mnorden81/CRSF-Multiswitch-Sound-ESP32-S3/firmware/README.md

# Firmware RC-Multiswitch-Sound v1.00

Arduino-Sketch `RC_Multiswitch_Sound/` fuer die Platine v0.9 mit ESP32-S3-DevKitC-1 N16R8. Nicht auf Hardware getestet.

Reine Zusammenfuehrung von RC-Multiswitch-ESP32-S3 v4.06 (Schaltteil, = Multiswitch-Basis V3/TXRX) und ESP32-Sound-Basis_Ziege-One v7.21 (Soundteil). Was neu ist, steht im Kopf von `RC_Multiswitch_Sound.ino`.

## Arduino IDE
1. Board-Verwalter: **esp32 von Espressif, Version 3.0.7**.
2. Bibliotheken: **Bolder Flight Systems SBUS 8.1.4**, **TinyGPSPlus 1.0.3**.
3. `RC_Multiswitch_Sound/RC_Multiswitch_Sound.ino` oeffnen.
4. Werkzeuge:
   - Board: **ESP32S3 Dev Module**
   - USB CDC On Boot: **Enabled**
   - Partition Scheme: **Minimal SPIFFS (1.9MB APP with OTA/128KB SPIFFS)**
   - PSRAM: Disabled
5. Hochladen. Danach gehen Updates auch per WLAN (Reiter WiFi, Firmware-Update) mit der Datei `RC_Multiswitch_Sound.ino.bin`.

Fertige Dateien baut GitHub Actions bei jedem Push (Artefakt `RC_Multiswitch_Sound-S3`): `*.ino.bin` = Update per WLAN, `*.merged.bin` = Komplett-Image ab Adresse 0x0 fuer USB.

## Dateien
| Datei | Inhalt |
|---|---|
| `RC_Multiswitch_Sound.ino` | Schaltteil (Ausgaenge, CRSF/SBUS, Lua-Menue, NVS "msw"), Ablauf setup/loop |
| `board_config.h` | Pins der Platine v0.9 |
| `webui.h` | Webserver und API des Schaltteils (`/api/status`, `/api/config`, `/api/output`, ...) |
| `webui_page.h` | Die Web-Seite (Schalt- und Soundteil zusammen) |
| `sound.h`, `sound.cpp` | Soundteil: Einstellungen (NVS "snd"), Wiedergabe, Motor, Einkanal, Lua-Felder |
| `sound_web.cpp` | API des Soundteils (`/api/sconfig`, `/api/sound`, `/api/debug`, SD-Dateien) |
| `XT_I2S_Audio.*` | I2S-Audio und WAV von der SD-Karte, unveraendert aus der Sound-Basis |
| `src/RC_Common/` | Gemeinsame Basis 1.2.0, unveraenderte Kopie (CI prueft `MANIFEST.sha256`) |

## SD-Karte
FAT32, Dateien im Hauptordner: `start.wav`, `loop.wav`, `shut.wav` (Motor) und `sound1.wav` bis `sound24.wav`. Hochladen geht auch per WLAN (Reiter Motor und Sounds). Sicherungen auf der Karte liegen in `/cfgbkup`.

## Lua-Menue (CRSF)
| Feld | Inhalt |
|---|---|
| 0-85 | wie RC-Multiswitch v4.06: Global (Switch Addr, CRSF Kanal), Ausgang 1-8, WLAN, UART B/C |
| 86-98 | Motor |
| 99-110 | Einstellungen: Sound-Adresse, RC-System, Sound-Einkanal (SBUS), Gruppenadressen, SBUS-Gruppen, WLAN jetzt |
| 111 | Geraetename |
| ab 112 | Sound 1 bis n, je 6 Felder; n = 8 (Vorgabe), 12, 16, 20 oder 23 (Web-UI, Reiter RC-System, Karte Kombimodul) |

Mehr als 23 Sounds passen nicht ins Lua-Menue (hoechstens 255 Felder). In der Web-UI sind immer alle 24 Sounds einstellbar.

## Bekannte Grenzen
- SBUS: Ohne Frames gilt das Signal nach 10 s als weg (Wert des Schaltteils, die Sound-Basis hatte 2 s). Bis dahin laufen Sounds weiter.
- RC-System, UART B/C, Status-LED und die Zahl der Lua-Sounds wirken erst nach einem Neustart.
