mnorden81/CRSF-Multiswitch-Sound-ESP32-S3/hardware/gehaeuse/Gehaeuse3D_Vorschau_gewinkelt.html

# Gehäuse Multiswitch-Sound S3, gewinkelte Stiftleiste

Version für eine gewinkelte Stiftleiste 2×8 (2,54 mm) an J1. Die Stecker der 8 Ausgänge kommen vorne durch die Wand, der Deckel ist über J1 geschlossen. Unterteil und Deckel für die Platine RC-Multiswitch-Sound-ESP32-S3 v0.9. Alle Maße stammen aus der KiCad-Datei, die Bauteilhöhen sind Annahmen (unten markiert).

Außen117,2 × 78,2

Höhe34,6 mm

Platine106 × 68,15

Ziehen = drehen · Mausrad/zwei Finger = zoomen · rechte Maustaste = schieben

Zustand Zu Deckel ab Explosion

Ansicht Schräg Links (USB, SD, A, 3S) Vorne (B, C, Lautspr.) Oben Unten

Zeigen Platine Deckel Deckel durchsichtig

## Öffnungen

Wand | Wofür | Größe B × H
links | USB-C des ESP32 (beide Buchsen) | 26,0 × 9,0
links | microSD-Karte, mit Griffmulde | 16,0 × 6,8
links | CN1 UART A (Empfänger) | 11,5 × 7,0
links | CN2 Akku 3S (Last 9-12,6 V) | 7,5 × 7,0
vorne | J5 UART B, J6 UART C | je 11,5 × 7,0
vorne | CN4 Lautsprecher | 7,5 × 7,0
vorne | J1 gewinkelte Stiftleiste 2×8, 8 Stecker 2-polig nebeneinander | 21,5 × 6,2
Deckel | Fenster BOOT/RESET und RGB-LED | 8,4 × 25,0
Deckel | 8 Lichtlöcher Kontroll-LEDs | Ø 3,4
Deckel | 9 Lüftungsschlitze über TPA3118 | 2 × 24
rechts | 6 Lüftungsschlitze | 2 × 12

## Annahmen, bitte prüfen

- Gewinkelte Leiste nach KiCad-Footprint PinHeader_2x08_P2.54mm_Horizontal: Kunststoff 5,1 mm hoch, steht ca. 0,6 mm über die Platinenkante, Pins ragen ca. 3,8 mm aus der Außenwand. Gelötet wird in die vorhandenen Löcher, die Platine bleibt unverändert. Oben liegen die Ausgänge, unten VLOAD.
- Innenhöhe 24 mm über der Platine. Das höchste Teil ist der Elko C1 (470 µF/35 V, jetzt 22 mm hoch angenommen), darüber 2 mm Luft.
- ESP sitzt 13 mm hoch (Unterkante ESP-Platine über der Hauptplatine). Danach richten sich USB-Ausschnitt und Fenster.
- Befestigung der Platine: Die Platine hat keine eigenen Montagelöcher. Ich nutze die 4 Löcher (3 mm) des TPA3118-Moduls, die durch Modul und Platine gehen. Dazu 6 Stützen am Rand.
- Kontroll-LEDs sitzen 19 mm unter dem Deckel. Durch die Löcher sieht man sie leuchten. Wer sie direkt im Deckel haben will, lötet sie mit langen Beinen ein.
- Lage von BOOT, RESET und RGB-LED auf dem DevKitC-1 ist nicht in der KiCad-Datei. Deshalb ein großes Fenster am USB-Ende statt einzelner Löcher.

## Drucken und Montieren

- Material PETG oder ASA (der TPA3118 wird warm, PLA kann weich werden). 0,2 mm Schicht, 3 Wände, 20 % Füllung.
- Unterteil mit dem Boden aufs Bett, Deckel mit der Oberseite aufs Bett (STL ist schon gedreht). Keine Stützen nötig.
- Platine: 4 × M3-Schraube von oben durch TPA3118-Modul und Platine in die Säulen (Kernloch 2,5 mm, selbstschneidend, Länge je nach Modulabstand ca. M3 × 16-20).
- Deckel: 4 × Blechschraube 2,5 × 8 (Senkkopf) in die Eckdome.
- Einbau ins Modell: 4 Laschen mit 3,4 mm Loch am Boden für Schrauben oder Kabelbinder.
- Wandstärke 2,2 mm, Boden und Deckel 2,0 mm, 5 mm Luft unter der Platine für Lötstellen.

## Dateien

- Gehaeuse_Unterteil_gewinkelt.stl / .step
- Gehaeuse_Deckel_gewinkelt.stl / .step
- gehaeuse.py --gewinkelt (Quelle, CadQuery, alle Maße als Parameter oben in der Datei)

STEP lässt sich in Fusion 360, FreeCAD oder KiCad öffnen und weiter ändern.
