mnorden81/CRSF-Multiswitch-Sound-ESP32-S3/hardware/gehaeuse/gehaeuse_links.png

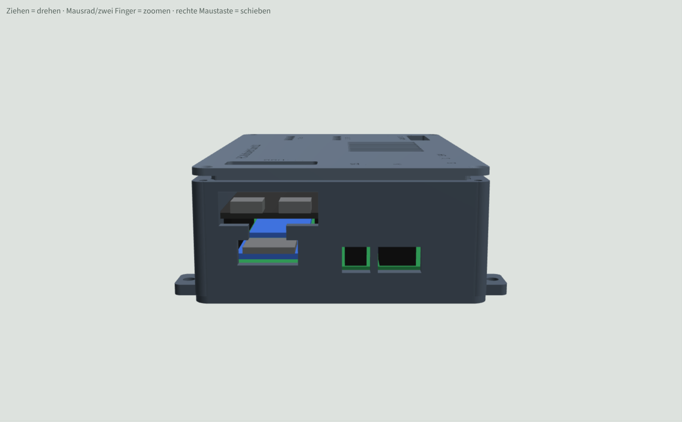
hardware/gehaeuse/gehaeuse_links.png
