mnorden81/CRSF-Multiswitch-Sound-ESP32-S3/hardware/gehaeuse/Gehaeuse_Deckel_gewinkelt.step

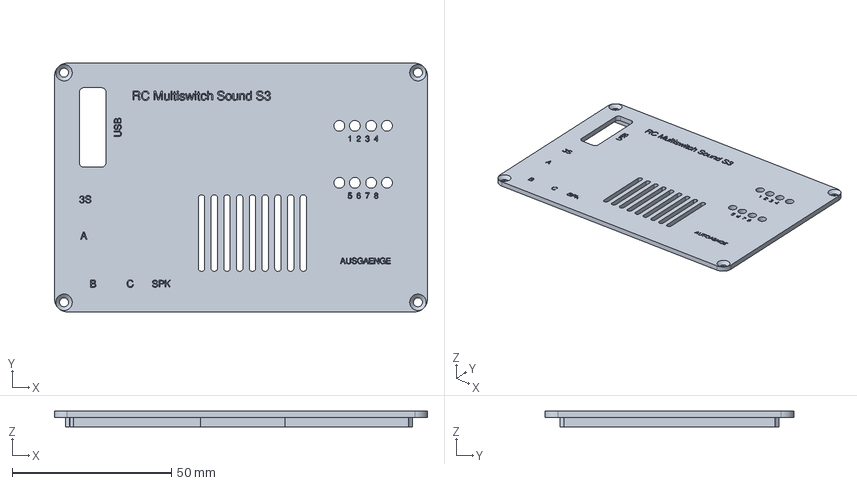
[picture p5: CAD file, 2026-10-30]
hardware/gehaeuse/Gehaeuse_Deckel_gewinkelt.step
117.2 x 78.2 x 5.00 mm
