mnorden81/CRSF-Multiswitch-Sound-ESP32-S3/hardware/RC-Multiswitch-Sound-ESP32-S3.pdf

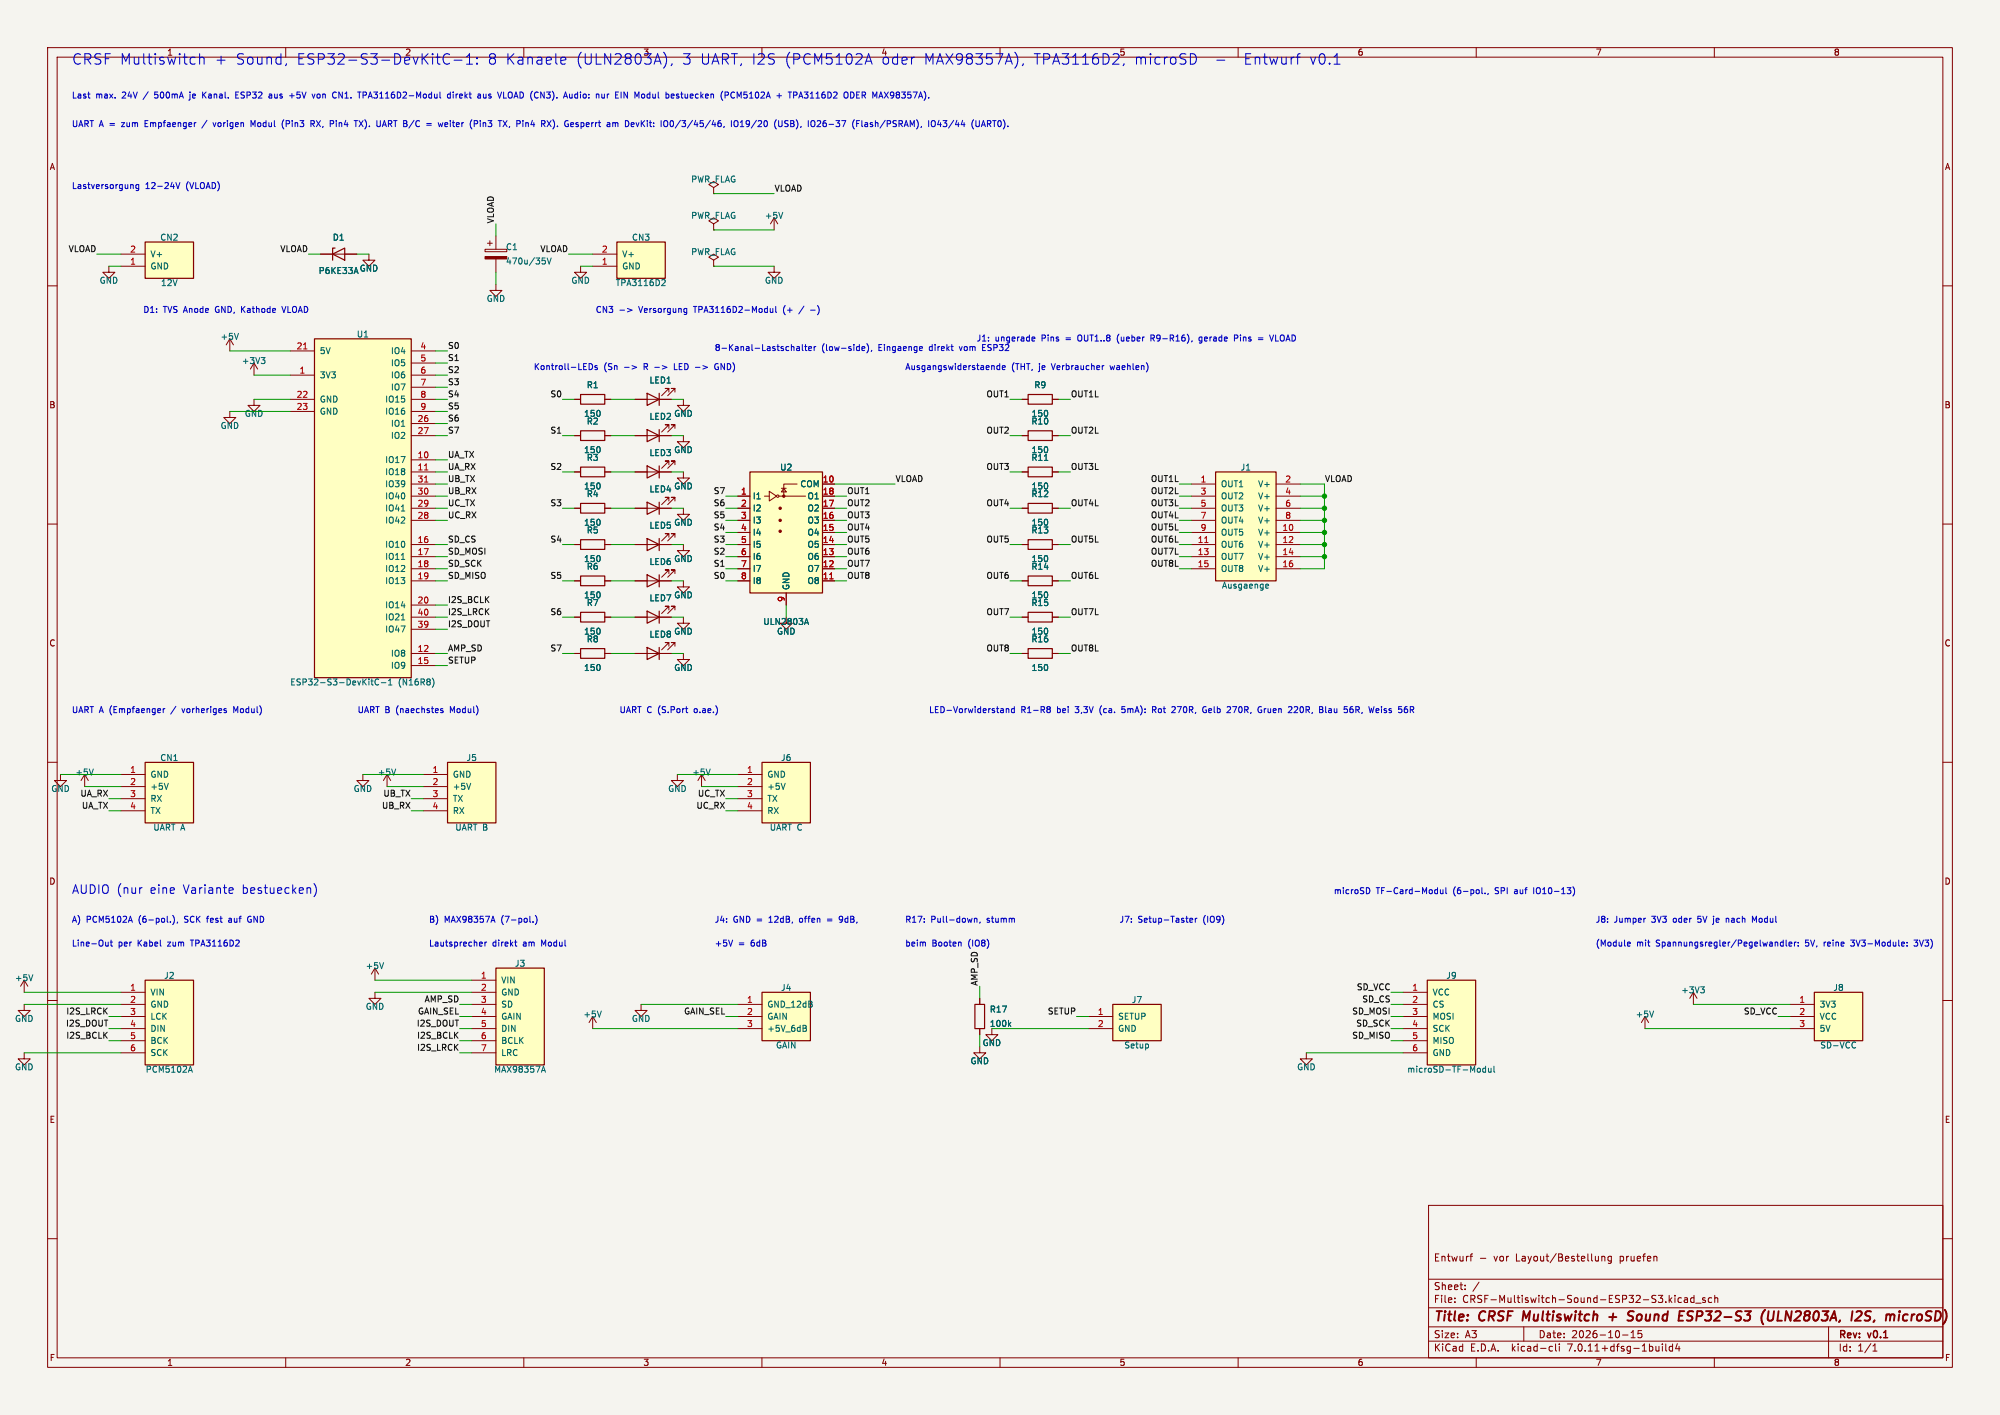
[picture p6: page 1]

D1: TVS Anode GND, Kathode VLOAD

AUDIO (nur eine Variante bestuecken)
