mnorden81/CRSF-Multiswitch-Sound-ESP32-S3/hardware/RC-Multiswitch-Sound-ESP32-S3.kicad_pcb

## KiCad design hardware/RC-Multiswitch-Sound-ESP32-S3.kicad_pcb (2026-10-30)

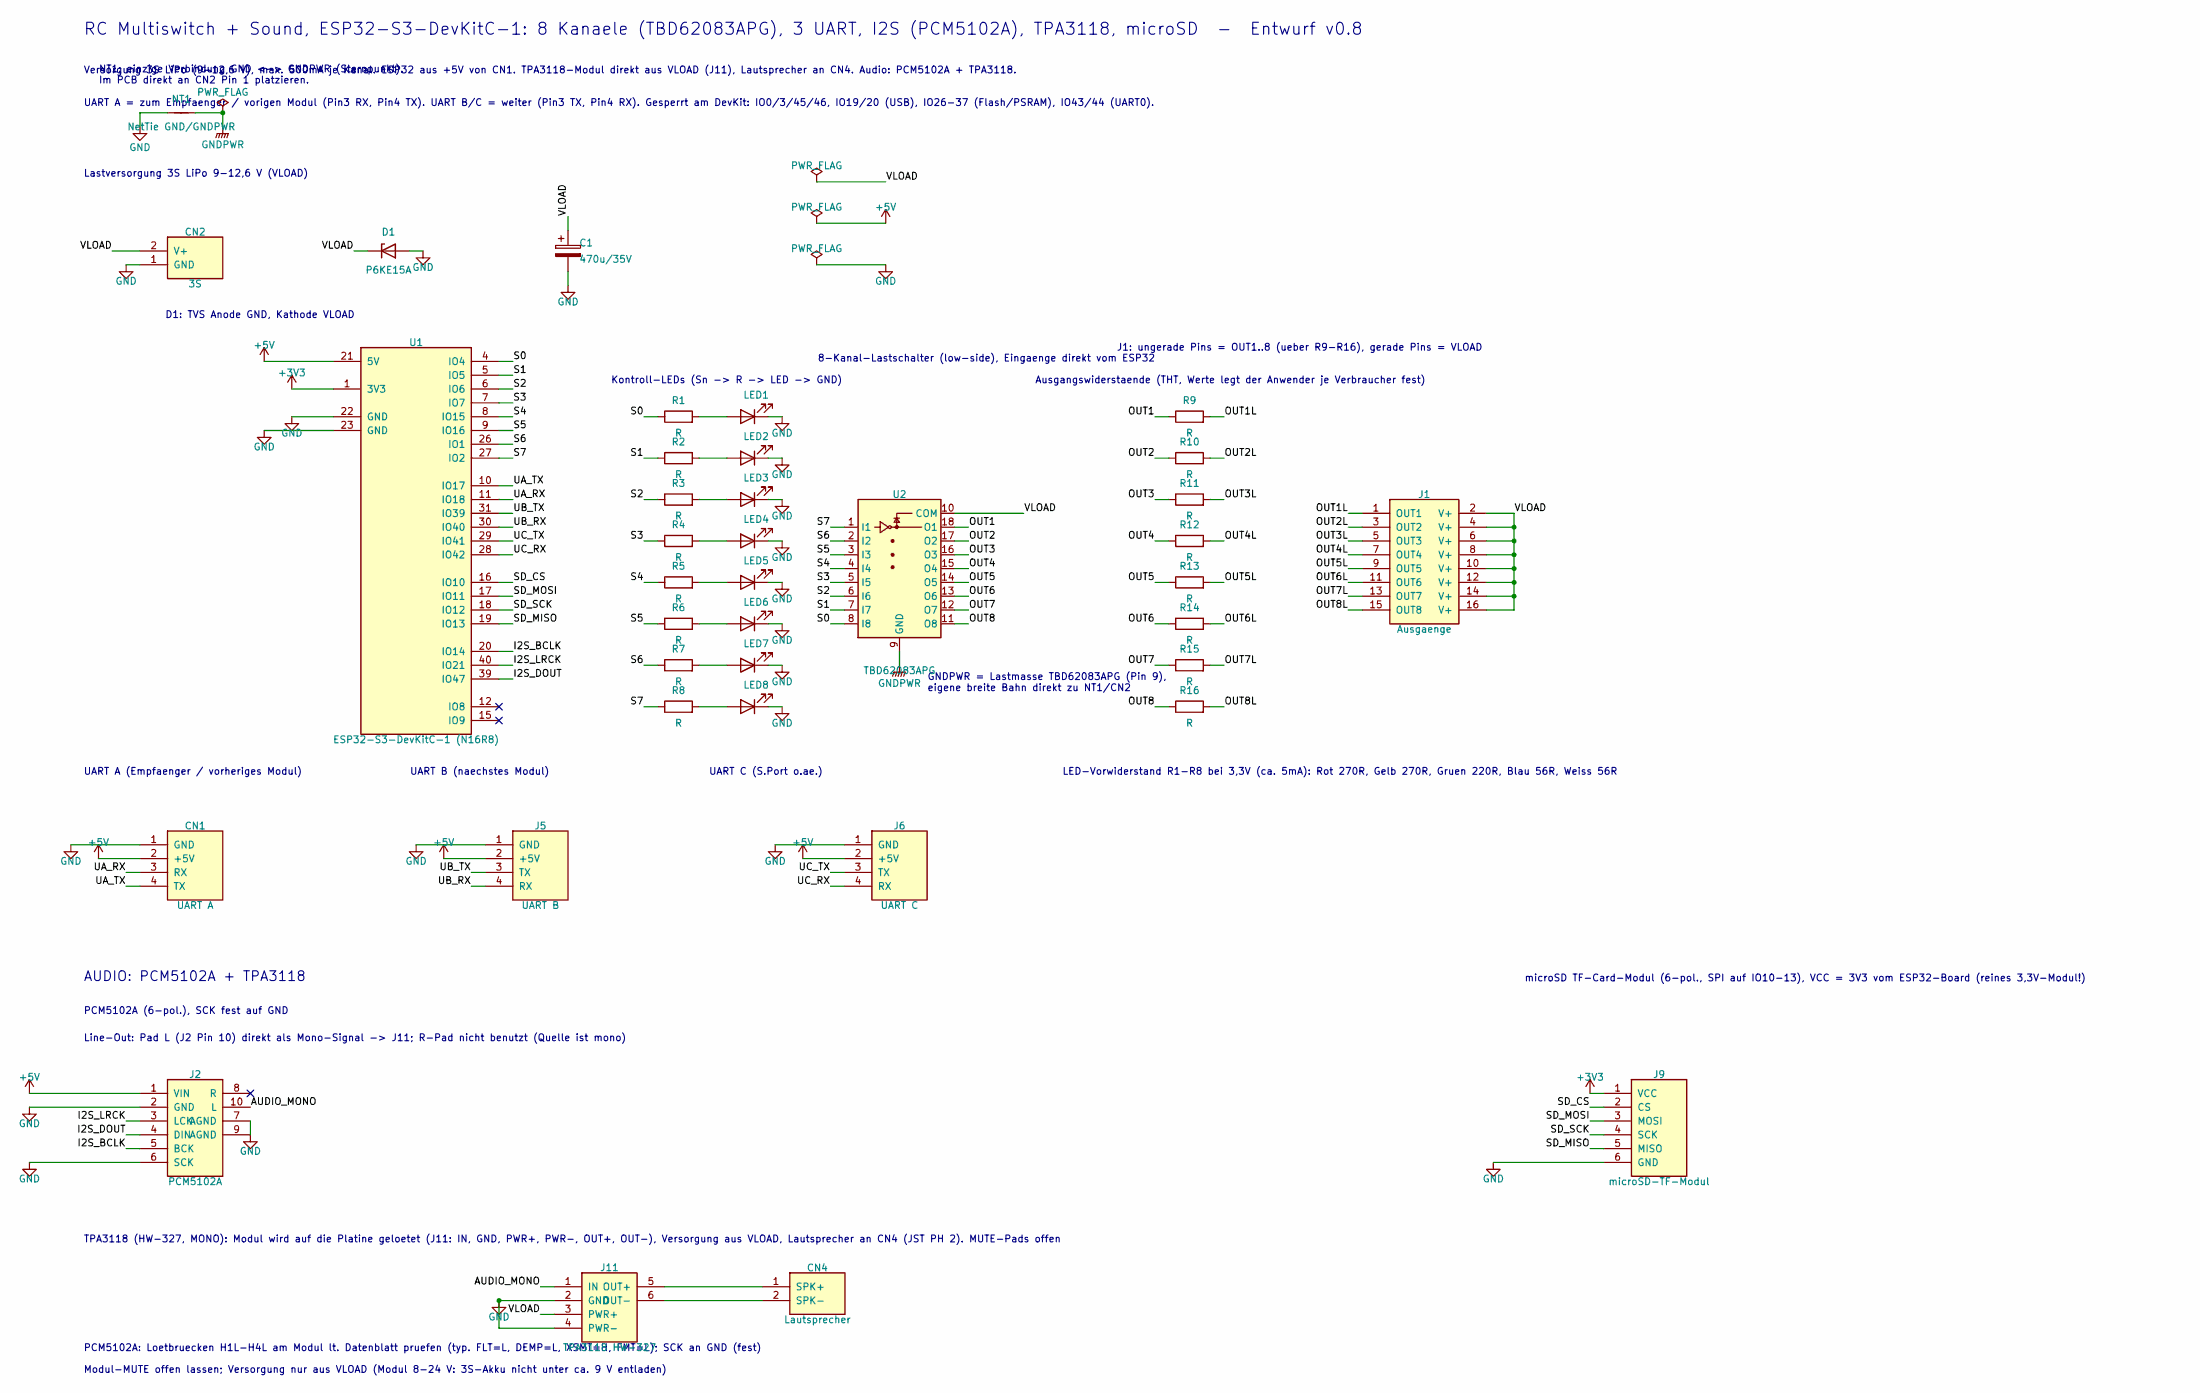
[picture p7: schematic RC-Multiswitch-Sound-ESP32-S3.kicad_sch, RC Multiswitch + Sound ESP32-S3 (TBD62083APG, I2S, microSD)]

Parts:
C1: 470u/35V; CP_Radial_D10.0mm_P5.00mm
CN1: UART A; JST_PH_S4B-PH-K_1x04_P2.00mm_Horizontal
CN2: 3S; JST_PH_S2B-PH-K_1x02_P2.00mm_Horizontal
CN4: Lautsprecher; JST_PH_S2B-PH-K_1x02_P2.00mm_Horizontal
D1: P6KE15A; D_DO-15_P12.70mm_Horizontal
J1: Ausgaenge; PinHeader_2x08_P2.54mm_Vertical
J2: PCM5102A; Mod_PCM5102A_GY_THT
J5: UART B; JST_PH_S4B-PH-K_1x04_P2.00mm_Horizontal
J6: UART C; JST_PH_S4B-PH-K_1x04_P2.00mm_Horizontal
J9: microSD-TF-Modul; Mod_microSD_SPI_THT
J11: TPA3118 HW-327; Mod_TPA3118_HW327_THT
LED1, LED2, LED3, LED4, LED5, LED6, LED7, LED8: LED; LED_D3.0mm
NT1: NetTie GND/GNDPWR; NetTie-2_SMD_Pad2.0mm
R1, R2, R3, R4, R5, R6, R7, R8, R9, R10, R11, R12, R13, R14, R15, R16: R; R_Axial_DIN0207_L6.3mm_D2.5mm_P7.62mm_Horizontal
U1: ESP32-S3-DevKitC-1 (N16R8); ESP32-S3-DevKitC-1_THT
U2: TBD62083APG; DIP-18_W7.62mm_Socket

Connections:
+3V3: J9.1 (VCC), U1.1 (3V3)
+5V: CN1.2 (+5V), J2.1 (VIN), J5.2 (+5V), J6.2 (+5V), U1.21 (5V)
/AUDIO_MONO: J2.10 (L), J11.1 (IN)
/I2S_BCLK: J2.5 (BCK), U1.20 (IO14)
/I2S_DOUT: J2.4 (DIN), U1.39 (IO47)
/I2S_LRCK: J2.3 (LCK), U1.40 (IO21)
/OUT1: R9.1, U2.18 (O1)
/OUT1L: J1.1 (OUT1), R9.2
/OUT2: R10.1, U2.17 (O2)
/OUT2L: J1.3 (OUT2), R10.2
/OUT3: R11.1, U2.16 (O3)
/OUT3L: J1.5 (OUT3), R11.2
/OUT4: R12.1, U2.15 (O4)
/OUT4L: J1.7 (OUT4), R12.2
/OUT5: R13.1, U2.14 (O5)
/OUT5L: J1.9 (OUT5), R13.2
/OUT6: R14.1, U2.13 (O6)
/OUT6L: J1.11 (OUT6), R14.2
/OUT7: R15.1, U2.12 (O7)
/OUT7L: J1.13 (OUT7), R15.2
/OUT8: R16.1, U2.11 (O8)
/OUT8L: J1.15 (OUT8), R16.2
/S0: R1.1, U1.4 (IO4), U2.8 (I8)
/S1: R2.1, U1.5 (IO5), U2.7 (I7)
/S2: R3.1, U1.6 (IO6), U2.6 (I6)
/S3: R4.1, U1.7 (IO7), U2.5 (I5)
/S4: R5.1, U1.8 (IO15), U2.4 (I4)
/S5: R6.1, U1.9 (IO16), U2.3 (I3)
/S6: R7.1, U1.26 (IO1), U2.2 (I2)
/S7: R8.1, U1.27 (IO2), U2.1 (I1)
/SD_CS: J9.2 (CS), U1.16 (IO10)
/SD_MISO: J9.5 (MISO), U1.19 (IO13)
/SD_MOSI: J9.3 (MOSI), U1.17 (IO11)
/SD_SCK: J9.4 (SCK), U1.18 (IO12)
/UA_RX: CN1.3 (RX), U1.11 (IO18)
/UA_TX: CN1.4 (TX), U1.10 (IO17)
/UB_RX: J5.4 (RX), U1.30 (IO40)
/UB_TX: J5.3 (TX), U1.31 (IO39)
/UC_RX: J6.4 (RX), U1.28 (IO42)
/UC_TX: J6.3 (TX), U1.29 (IO41)
/VLOAD: C1.1, CN2.2 (V+), D1.1 (K), J1.2 (V+), J1.4 (V+), J1.6 (V+), J1.8 (V+), J1.10 (V+), J1.12 (V+), J1.14 (V+), J1.16 (V+), J11.3 (PWR+), U2.10 (COM)
GND: C1.2, CN1.1 (GND), CN2.1 (GND), D1.2 (A), J2.2 (GND), J2.6 (SCK), J2.7 (AGND), J2.9 (AGND), J5.1 (GND), J6.1 (GND), J9.6 (GND), J11.2 (GND), J11.4 (PWR-), LED1.1 (K), LED2.1 (K), LED3.1 (K), LED4.1 (K), LED5.1 (K), LED6.1 (K), LED7.1 (K), LED8.1 (K), NT1.1, U1.22 (GND), U1.23 (GND)
GNDPWR: NT1.2, U2.9 (GND)
unnamed: CN4.1 (SPK+), J11.5 (OUT+)
unnamed: CN4.2 (SPK-), J11.6 (OUT-)
unnamed: LED1.2 (A), R1.2
unnamed: LED2.2 (A), R2.2
unnamed: LED3.2 (A), R3.2
unnamed: LED4.2 (A), R4.2
unnamed: LED5.2 (A), R5.2
unnamed: LED6.2 (A), R6.2
unnamed: LED7.2 (A), R7.2
unnamed: LED8.2 (A), R8.2

Notes on the sheet:
D1: TVS Anode GND, Kathode VLOAD
Versorgung 3S LiPo (9-12,6 V), max. 500mA je Kanal. ESP32 aus +5V von CN1. TPA3118-Modul direkt aus VLOAD (J11), Lautsprecher an CN4. Audio: PCM5102A + TPA3118.
AUDIO: PCM5102A + TPA3118
Ausgangswiderstaende (THT, Werte legt der Anwender je Verbraucher fest)
LED-Vorwiderstand R1-R8 bei 3,3V (ca. 5mA): Rot 270R, Gelb 270R, Gruen 220R, Blau 56R, Weiss 56R
PCM5102A: Loetbruecken H1L-H4L am Modul lt. Datenblatt pruefen (typ. FLT=L, DEMP=L, XSMT=H, FMT=L); SCK an GND (fest)
J1: ungerade Pins = OUT1..8 (ueber R9-R16), gerade Pins = VLOAD
Line-Out: Pad L (J2 Pin 10) direkt als Mono-Signal -> J11; R-Pad nicht benutzt (Quelle ist mono)
RC Multiswitch + Sound, ESP32-S3-DevKitC-1: 8 Kanaele (TBD62083APG), 3 UART, I2S (PCM5102A), TPA3118, microSD - Entwurf v0.8
microSD TF-Card-Modul (6-pol., SPI auf IO10-13), VCC = 3V3 vom ESP32-Board (reines 3,3V-Modul!)
PCM5102A (6-pol.), SCK fest auf GND
UART A (Empfaenger / vorheriges Modul)
Modul-MUTE offen lassen; Versorgung nur aus VLOAD (Modul 8-24 V: 3S-Akku nicht unter ca. 9 V entladen)
Lastversorgung 3S LiPo 9-12,6 V (VLOAD)
UART C (S.Port o.ae.)
Kontroll-LEDs (Sn -> R -> LED -> GND)
UART A = zum Empfaenger / vorigen Modul (Pin3 RX, Pin4 TX). UART B/C = weiter (Pin3 TX, Pin4 RX). Gesperrt am DevKit: IO0/3/45/46, IO19/20 (USB), IO26-37 (Flash/PSRAM), IO43/44 (UART0).
UART B (naechstes Modul)
TPA3118 (HW-327, MONO): Modul wird auf die Platine geloetet (J11: IN, GND, PWR+, PWR-, OUT+, OUT-), Versorgung aus VLOAD, Lautsprecher an CN4 (JST PH 2). MUTE-Pads offen
8-Kanal-Lastschalter (low-side), Eingaenge direkt vom ESP32
NT1: einzige Verbindung GND <-> GNDPWR (Sternpunkt). Im PCB direkt an CN2 Pin 1 platzieren.
GNDPWR = Lastmasse TBD62083APG (Pin 9), eigene breite Bahn direkt zu NT1/CN2

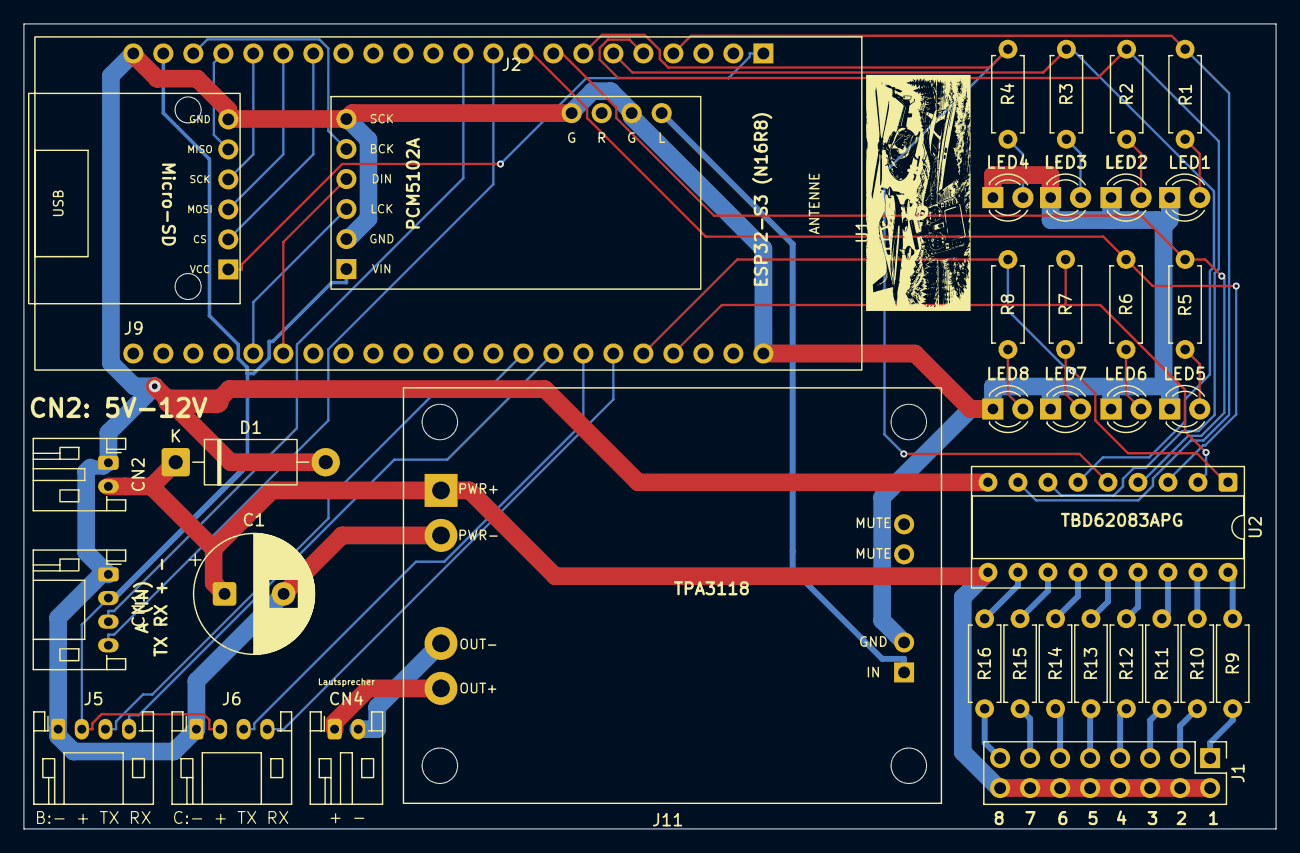
[picture p8: board RC-Multiswitch-Sound-ESP32-S3.kicad_pcb from above]

Board: 2 copper layers, 106.0 x 68.2 mm, 38 parts (0 on the bottom side), 53 nets.
