mnorden81/CRSF-Multiswitch-Sound-ESP32-S3/(commit log)

2026-10-16 Ausgangsstand aus KiCad-ZIP vom 2026-10-15
    Hardware nach hardware/, leerer Ordner firmware/, README und .gitignore.
    Claude-Session: https://claude.ai/code/session_017Lns5pPfH18AXUiHEWcrs9
    [CRSF-Multiswitch-Sound-ESP32-S3.kicad_pcb, CRSF-Multiswitch-Sound-ESP32-S3.kicad_sch]
2026-10-16 Projektbeschreibung in README und docs/Projektbeschreibung.docx
    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
2026-10-18 Umbenennung CRSF-Multiswitch -> RC-Multiswitch
    Neutraler Name, weil der Multiswitch neben CRSF auch SBUS versteht.
    README, docs (MD und DOCX), KiCad-Projekt (Dateinamen, Projekt- und
    Sheet-Verweise, Titel), Sketch-Ordner und CI-Pfad angepasst.
    Geraetename, WLAN-SSID und Config-Export bleiben "MultiSwitch".
    Claude-Session: https://claude.ai/code/session_01Np9GkYmRMGJmd89YiKPa21
    [RC-Multiswitch-Sound-ESP32-S3.kicad_pcb, RC-Multiswitch-Sound-ESP32-S3.kicad_sch]
2026-10-18 Lokale KiCad-Staende vom 2026-10-17/18 uebernehmen
    Die Arbeit lag nur lokal (nicht auf GitHub) und wurde beim Abgleich
    nach der Umbenennung ueberschrieben. Wiederhergestellt aus
    backups/vor-umbenennung, Dateinamen und Projektverweise auf
    RC-Multiswitch angepasst.
    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
    [RC-Multiswitch-Sound-ESP32-S3.kicad_pcb, RC-Multiswitch-Sound-ESP32-S3.kicad_sch]
2026-10-18 Widerstandswerte R1-R16 entfernt, Anwender legt sie aus
    - R1-R16 ohne Wert (Schaltplan + PCB), Hinweis im Schaltplan angepasst
    - Projektbeschreibung, README, README-hardware: Anwender legt Werte selbst aus, LED-Empfehlung im Schaltplan
    - D1 P6KE15A und 3S-Versorgung bleiben (TPA3118 braucht >= 8 V)
    Claude-Session: https://claude.ai/code/session_015ZTAHN4h1MhX6WfGWCfmx3
    [RC-Multiswitch-Sound-ESP32-S3.kicad_pcb, RC-Multiswitch-Sound-ESP32-S3.kicad_sch]
2026-10-18 PCB: Routing von Martins PC übernommen, VLOAD-Bahnen auf 0,4 mm
    Übernimmt das lokal mit Freerouting geroutete Layout (Stand 18.10.2026
    19:53) und setzt alle 28 Leiterbahn-Segmente des Netzes /VLOAD von
    0,2 mm auf 0,4 mm Breite. Sonst unverändert, CRLF beibehalten.
    Claude-Session: https://claude.ai/code/session_018bh1aktNNbeTvdMLiwxhbB
    [RC-Multiswitch-Sound-ESP32-S3.kicad_pcb]
2026-10-18 PR #4 rückgängig: PCB wieder auf Stand vor VLOAD 0,4 mm
    Auf Wunsch von Martin zurückgenommen.
    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
    [RC-Multiswitch-Sound-ESP32-S3.kicad_pcb]
2026-10-19 Schaltplan v0.9: Lastmasse GNDPWR mit NetTie, Netzklassen und DRC-Regeln
    - ULN2803 Pin 9 an eigenes Netz GNDPWR, Verbindung zu GND nur ueber
    NetTie NT1 (im PCB direkt an CN2 Pin 1 platzieren), PWR_FLAG an GNDPWR
    - Netzklassen: Power 1,5 mm (GND, GNDPWR, /VLOAD, Lautsprecher CN4),
    Kanal 0,5 mm (/OUT*)
    - kicad_dru: Mindestbreite Power 1,0 mm, Kanal 0,4 mm
    - README-hardware ergaenzt; PCB unveraendert
    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
    [RC-Multiswitch-Sound-ESP32-S3.kicad_sch]
2026-10-19 PCB: Platzierung/Routing von Martin (lokaler Stand), ERC-Bericht v0.9
    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
    [RC-Multiswitch-Sound-ESP32-S3.kicad_pcb]
2026-10-19 DRC-Regel: GND von Power-Mindestbreite ausnehmen (LED-Rueckleiter duerfen duenner sein)
    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
2026-10-19 PCB: Martins Stand 19.10. (Leiterbahnbreiten angepasst), DRC-Bericht
    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
    [RC-Multiswitch-Sound-ESP32-S3.kicad_pcb]
2026-10-19 PCB: Martins Stand 20.10. 00:17, DRC-Bericht
    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
    [RC-Multiswitch-Sound-ESP32-S3.kicad_pcb]
2026-10-20 PCB: Martins Stand 20.10. (nach Prüfung C3/S3)
    [RC-Multiswitch-Sound-ESP32-S3.kicad_pcb]
2026-10-28 Firmware v1.00: Multiswitch V3 und Sound-Basis v7.21 zusammengefuehrt
    Arduino-Sketch firmware/RC_Multiswitch_Sound fuer Platine v0.9
    (ESP32-S3-DevKitC-1). Schaltteil aus RC-Multiswitch-ESP32-S3 v4.06,
    Soundteil aus ESP32-Sound-Basis v7.21 (SD-Karte, I2S PCM5102A).
    Zwei Adressen (Schalt- und Sound-Adresse), Status-LED IO48/IO38,
    Lua-Sounds 8 bis 23, Name je Sound, gemeinsamer Export/Backup.
    CI baut mit arduino-cli (Core 3.0.7, Minimal SPIFFS).
    Claude-Session: https://claude.ai/code/session_0118D4qsV1nAfMEzonwsrZXB
2026-10-28 Doku: README, firmware/README und Projektbeschreibung fuer Firmware v1.00
    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
2026-10-28 Gehaeuse fuer Platine v0.9: Unterteil und Deckel als STL/STEP
    3D-Druck-Gehaeuse aus der KiCad-Platine abgeleitet (CadQuery-Quelle
    gehaeuse.py, Vorschau-HTML, README). Platine wird ueber die vier
    Befestigungsloecher des TPA3118-Moduls verschraubt. Annahmen: Elko C1
    22 mm hoch, ESP 13 mm ueber der Platine.
    Claude-Session: https://claude.ai/code/session_0118D4qrEvBcHBrvHSSiZnG7
    [Gehaeuse_Deckel.step, Gehaeuse_Deckel.stl, Gehaeuse_Unterteil.step, Gehaeuse_Unterteil.stl]
2026-10-30 Hardware: TBD62083APG statt ULN2803A
    ULN2803A ist abgekuendigt. Der TBD62083APG (DMOS) hat dieselbe Pinbelegung und passt in denselben Sockel, Leiterbahnen und Netze bleiben unveraendert. Schaltplan-Symbol, Bauteilwert, Bestueckungsdruck und Doku angepasst.
    Claude-Session: https://claude.ai/code/session_0118D4qppRkb6gR5m3R2CZyV
    [RC-Multiswitch-Sound-ESP32-S3.kicad_pcb, RC-Multiswitch-Sound-ESP32-S3.kicad_sch]
2026-10-30 Gehaeuse: Version mit gewinkelter Stiftleiste 2x8 fuer J1
    gehaeuse.py --gewinkelt erzeugt Unterteil/Deckel *_gewinkelt: Stecker der
    8 Ausgaenge seitlich durch einen Wandschlitz 21,5 x 6,2 mm, Deckel ueber
    J1 geschlossen. Platine unveraendert. Dazu README-Abschnitt, 3D-Vorschau
    und Bild. Die stehende Version bleibt unveraendert (Volumen geprueft).
    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
    [Gehaeuse_Deckel_gewinkelt.step, Gehaeuse_Deckel_gewinkelt.stl, Gehaeuse_Unterteil_gewinkelt.step, Gehaeuse_Unterteil_gewinkelt.stl]
